joshajohnson/macro4/docs/1810291524_XKB-Enterprise-TS-1101VS-C-A-A_C318936.pdf

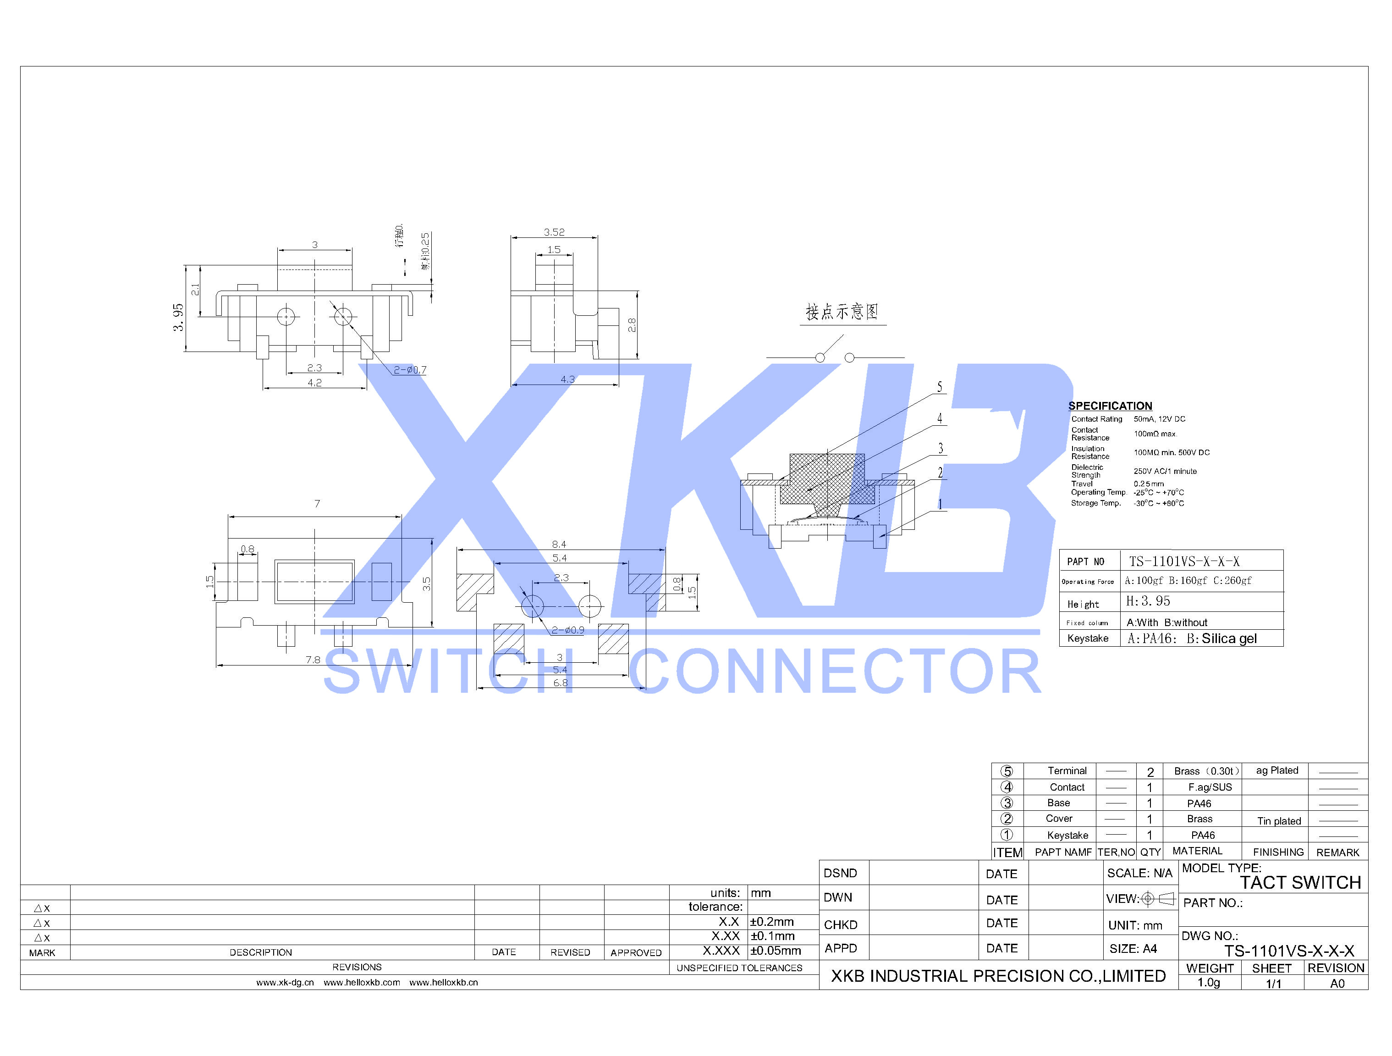
[picture p2: page 1]
