joshajohnson/macro4/hardware/0.2/art/art_back.png

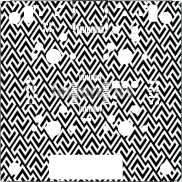
hardware/0.2/art/art_back.png
