joshajohnson/macro4/hardware/0.2/art/pattern_top.png

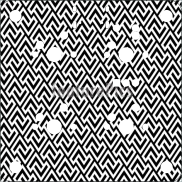
hardware/0.2/art/pattern_top.png
