joshajohnson/macro4/hardware/0.2/macro4.kicad_pcb

## KiCad design hardware/0.2/macro4.kicad_pcb (2020-07-26)

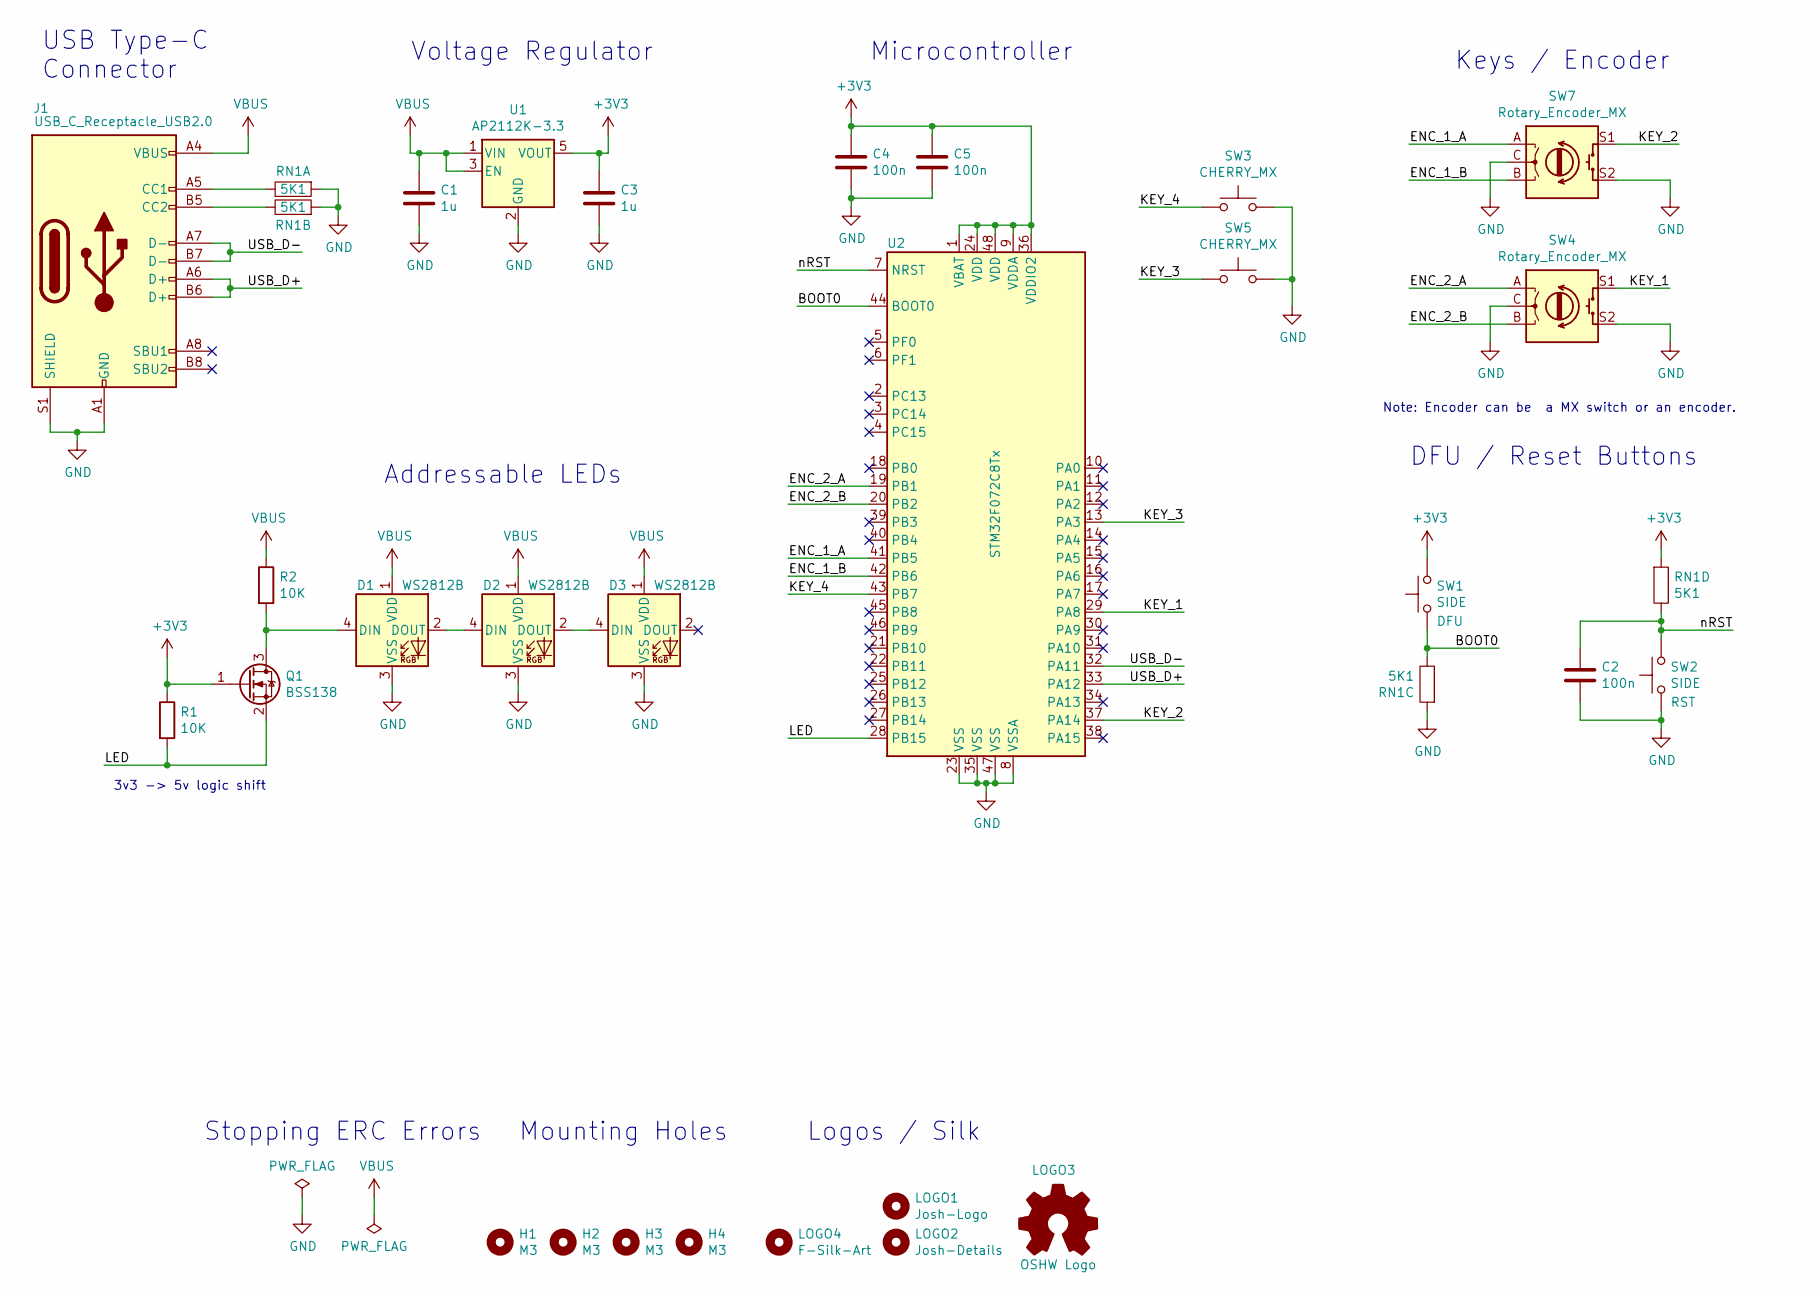
[picture p6: schematic macro4.sch, macro4 keyboard]

Parts:
C1, C3: 1u; C_0603_1608Metric; MPN CL10A105MP8NNNC; LCSC C15849
C2, C4, C5: 100n; C_0603_1608Metric; MPN CL10B104KB8NNNC; LCSC C14663
D1, D2, D3: WS2812B; LED_WS2812B_PLCC4_5.0x5.0mm_P3.2mm; MPN WS2812B-B; DigiKey 1528-1104-ND
H1, H2, H3, H4: M3; MountingHole_3.2mm_M3
J1: USB_C_Receptacle_USB2.0; USB_C_U262-161N-4BVC11; MPN U262-161N-4BVC11; LCSC C319148
LOGO1: Josh-Logo; josh-johnson-logo-17x3
LOGO2: Josh-Details; josh-details
LOGO3: OSHW Logo; OSHW_Logo_3.6x3.6_F.Mask
LOGO4: F-Silk-Art; pattern_top
Q1: BSS138; SOT-23; MPN BSS138P,215; LCSC C75547
R1, R2: 10K; R_0603_1608Metric; MPN CR0603-JW-103ELF; DigiKey CR0603-JW-103ELFCT-ND
RN1: 5K1; R_Array_Convex_4x0603; MPN CAY16-512J4LF; LCSC C12028
SW1, SW2: SIDE; Panasonic_EVQPUL_EVQPUC; MPN PTS840GMSMTRLFS; LCSC C221909
SW3, SW5: CHERRY_MX; MX_KEYSWITCH
SW4, SW7: Rotary_Encoder_MX; MX_KEYSWITCH_ENCODER
U1: AP2112K-3.3; SOT-23-5; MPN AP2112K-3.3TRG1; LCSC C51118
U2: STM32F072C8Tx; LQFP-48_7x7mm_P0.5mm; MPN STM32F072C8T6; LCSC C80488

Connections:
+3V3: C3.2, C4.1, C5.1, Q1.1 (G), R1.1, RN1.1, SW1.2, U1.5 (VOUT), U2.1 (VBAT), U2.9 (VDDA), U2.24 (VDD), U2.36 (VDDIO2), U2.48 (VDD)
/BOOT0: RN1.7, SW1.1, U2.44 (BOOT0)
/ENC_1_A: SW7.A, U2.41 (PB5)
/ENC_1_B: SW7.B, U2.42 (PB6)
/ENC_2_A: SW4.A, U2.19 (PB1)
/ENC_2_B: SW4.B, U2.20 (PB2)
/KEY_1: SW7.S1, U2.37 (PA14)
/KEY_2: SW4.S1, U2.29 (PA8)
/KEY_3: SW5.1, U2.13 (PA3)
/KEY_4: SW3.1, U2.43 (PB7)
/LED: Q1.2 (S), R1.2, U2.28 (PB15)
/USB_D+: J1.A6 (D+), J1.B6 (D+), U2.33 (PA12)
/USB_D-: J1.A7 (D-), J1.B7 (D-), U2.32 (PA11)
/nRST: C2.1, RN1.8, SW2.2, U2.7 (NRST)
GND: C1.1, C2.2, C3.1, C4.2, C5.2, D1.3 (VSS), D2.3 (VSS), D3.3 (VSS), J1.A1 (GND), J1.A12 (GND), J1.B1 (GND), J1.B12 (GND), J1.S1 (SHIELD), RN1.2, RN1.3, RN1.4, SW2.1, SW3.2, SW4.C, SW4.S2, SW5.2, SW7.C, SW7.S2, U1.2 (GND), U2.8 (VSSA), U2.23 (VSS), U2.35 (VSS), U2.47 (VSS)
unnamed: D1.2 (DOUT), D2.4 (DIN)
unnamed: D1.4 (DIN), Q1.3 (D), R2.2
unnamed: D2.2 (DOUT), D3.4 (DIN)
unnamed: J1.A5 (CC1), RN1.5
unnamed: J1.B5 (CC2), RN1.6
VBUS: C1.2, D1.1 (VDD), D2.1 (VDD), D3.1 (VDD), J1.A4 (VBUS), J1.A9 (VBUS), J1.B4 (VBUS), J1.B9 (VBUS), R2.1, U1.1 (VIN), U1.3 (EN)

Notes on the sheet:
USB Type-C Connector
Voltage Regulator
Microcontroller
DFU / Reset Buttons
Keys / Encoder
Note: Encoder can be a MX switch or an encoder.
Mounting Holes
Stopping ERC Errors
Addressable LEDs
3v3 -> 5v logic shift
Logos / Silk

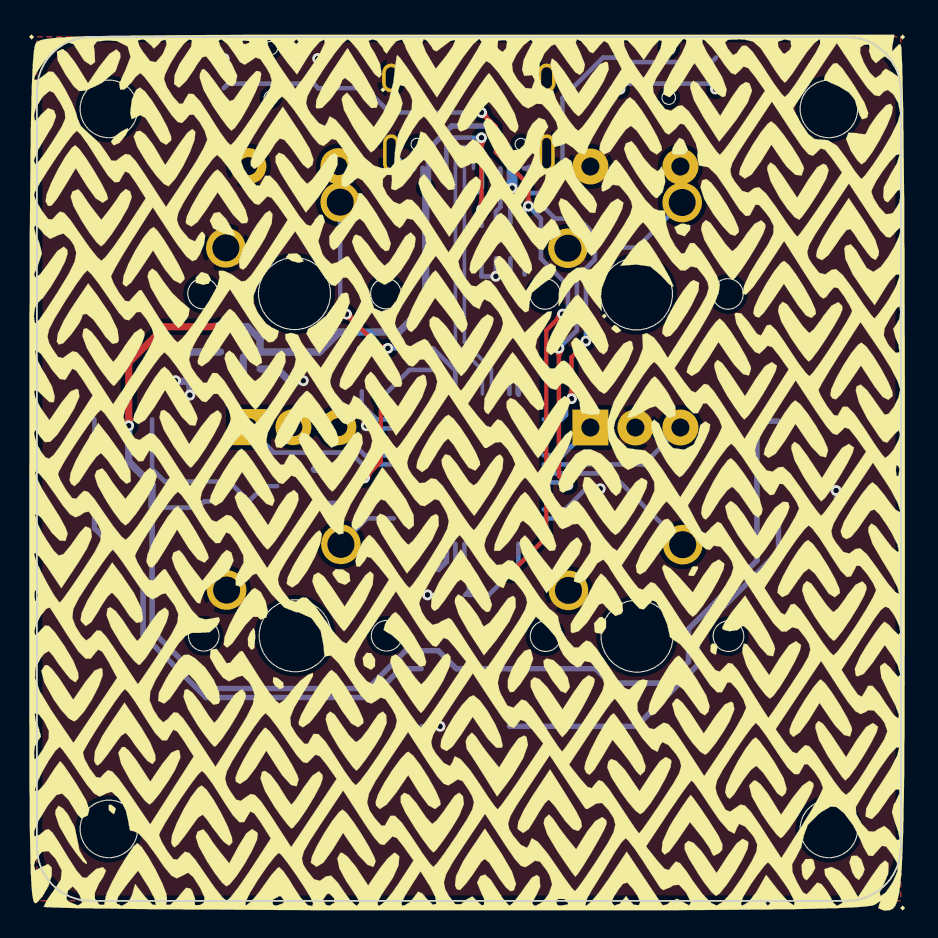
[picture p7: board macro4.kicad_pcb from above]

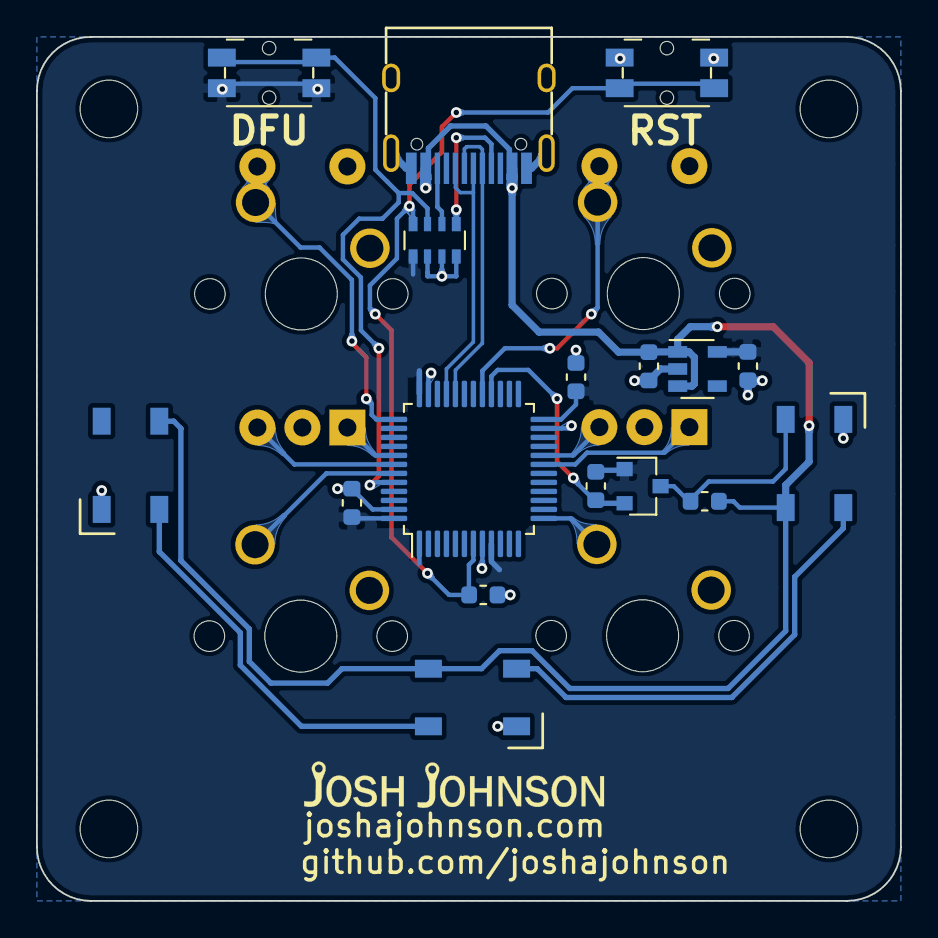
[picture p8: board macro4.kicad_pcb from below]

Board: 2 copper layers, 48.0 x 48.0 mm, 29 parts (20 on the bottom side), 21 nets.
