joshajohnson/macro4/(commit log)

2020-01-04 initial layout done
    [macro4.kicad_pcb, macro4.sch]
2020-01-07 add RGB and silk to macro4
    [macro4.kicad_pcb, macro4.sch]
2020-01-15 change buttons
    [macro4.kicad_pcb, macro4.sch]
2020-01-17 update due to breaking lib change
    [macro4.kicad_pcb, macro4.sch]
2020-05-23 added second encoder, fixed panelisation script
    [macro4.kicad_pcb, macro4.sch]
2020-06-28 fix assembly version bug
